bapshago/AngryPixieDash/AngryPixieDash_Reference.docx

Angry Pixie Dash

EV Dashboard · Porsche 928 / Nissan Leaf Stack / ZombieVerter

Uniboard PCB · Wiring · Configuration · Code Reference

Rev 1.0 · EasyEDA · Designed by Sayantan98

# 1. System Overview

The Angry Pixie Dash is a self-contained EV dashboard built around the Angry Pixie Garage Uniboard. The board integrates an ESP32-WROOM-32E module, SN65HVD230 CAN transceiver, 4-channel relay outputs, 5V buck converter, USB-C programming port, level-shifted GPIO outputs, and an optocoupler input — all on a single PCB designed to mount directly in the vehicle.

The firmware reads native Nissan Leaf CAN1 frames directly from the ZombieVerter CAN1 bus and serves a live web dashboard over a built-in WiFi access point. No external router or internet connection is required.

Key specifications:

• Microcontroller: ESP32-WROOM-32E, dual-core 240MHz, 4MB flash, WiFi + BLE

• CAN: SN65HVD230DR transceiver, 500 kbps, ISO 11898-2, onboard switchable termination

• Power input: 9–28V DC via CN4 (24V nominal), onboard 15A fuse, AP63205WU-7 buck to 5V

• Relay outputs: 4× SRD-5VDC-SL-A SPDT, 10A contacts, NO outputs on CN1

• Level-shifted outputs: GPIO21, GPIO23, GPIO33 available at 5V logic level

• Programming: USB-C via CH340C (auto-reset circuit included)

• WiFi: ESP32 soft AP — SSID: ESP32-EV-Dashboard, Password: evdash1234

• Web interface: http://192.168.4.1 (Driver View + Diagnostics pages)

# 2. Uniboard PCB

## 2.1 Board Overview

The Uniboard is a two-layer PCB with all components on the top side. Mounting holes are provided at four corners. The board is divided into functional zones visible in the PCB render:

• Top-left: relay cluster (K1-K4) with flyback diodes and transistor drivers

• Top-centre/right: JST XH output connectors (CN1-CN7)

• Centre: ESP32-WROOM-32E module with GPIO header breakouts H1 and H2

• Centre-left: USB-C connector, CH340C, auto-reset circuit, RST/BOOT buttons

• Centre-right: SN65HVD230 CAN transceiver, level shifters, termination jumpers

• Bottom-left: 24V input connector CN4 with fuse FH1 and AP63205WU-7 buck converter

• Bottom-centre: power indicator LED

## 2.2 Bill of Materials

All components sourced from LCSC. Key ICs and their roles:

Ref | Part | Qty | Function
U2 | ESP32-WROOM-32E (4MB) | 1 | Main microcontroller — WiFi, BLE, dual-core 240MHz, 4MB flash
U6 | SN65HVD230DR | 1 | CAN transceiver — 3.3V, connects ESP32 TWAI to CAN bus
U1 | AP2112K-3.3TRG1 | 1 | 3.3V LDO regulator — powers ESP32 and logic from 5V rail
U9 | AP63205WU-7 | 1 | 5V 2A buck converter — steps down vehicle 24V input to 5V
U5 | CH340C | 1 | USB-UART bridge — ESP32 programming and serial monitor
U3 | EL357N | 1 | Optocoupler — isolated digital input for OPTO signal
K1-4 | SRD-5VDC-SL-A | 4 | 5V SPDT relay — NO contacts rated for external switching
Q1 | MUN5214DW1T1G | 1 | Dual NPN pre-biased transistor — USB auto-reset (DTR/RTS)
Q2-5 | MMBT2222A | 4 | NPN transistor — relay coil drivers
Q6-8 | BSS138 | 3 | N-channel MOSFET — 3.3V to 5V logic level shifters
FH1 | PTF-15 | 1 | 15A blade fuse holder — protects 24V input supply
D1 | B5819W | 1 | Schottky diode — reverse polarity protection on VUSB
D2-5 | LL4148 | 4 | Signal diode — relay flyback suppression
L1 | 4.7uH | 1 | Inductor — buck converter output filter
R12 | 120Ω | 1 | CAN bus termination resistor — end-of-line termination
R10 | 10kΩ | 1 | SN65HVD230 RS pin pull-down — sets high-speed mode
JP1,JP2 | 2-pin jumper header | 2 | CAN termination jumper — in=terminated, out=unterminated
USB2 | USB-C connector | 1 | Programming and power input port
CN1 | B5B-XH-AM (5-pin) | 1 | Relay output connector — NO1-4 + GND
CN2-4 | B2B-XH-A (2-pin) | 3 | Bottom connectors — GND/P33, P21/P23, GND/D22
CN5 | B2B-XH-A (2-pin) | 1 | CAN bus connector — CANH / CANL
CN6 | B2B-XH-A (2-pin) | 1 | Level-shifted output — D23_H / D21_H
CN7 | B2B-XH-A (2-pin) | 1 | Level-shifted output — D33_H
H1,H2 | 10-pin header | 2 | ESP32 GPIO breakout — left and right pin rows

## 2.3 Connector Reference

All signal connectors use JST XH 2.54mm pitch. Mating connectors: JST XH series crimped housings.

Connector | Type | Function | Details
CN1 | B5B-XH 5-pin | Relay outputs | Pin1=NO1, Pin2=NO2, Pin3=NO3, Pin4=NO4, Pin5=GND. Relay contacts rated for load switching — see relay section for voltage limits.
CN2 | B2B-XH 2-pin | GND / GPIO33 | Pin1=GND, Pin2=GPIO33. Also exposed as D33_H (5V level) via CN7.
CN3 | B2B-XH 2-pin | GPIO21 / GPIO23 | Pin1=GPIO21, Pin2=GPIO23. Also exposed as D21_H / D23_H (5V level) via CN6.
CN4 | B2B-XH 2-pin | 24V power input | Pin1=+24V, Pin2=GND. Main vehicle power input — connect to run-mode switched supply. Protected by fuse FH1 (15A).
CN5 | B2B-XH 2-pin | CAN bus | Pin1=CANH, Pin2=CANL. Connect to ZombieVerter CAN1. Onboard 120Ω termination selectable via JP1/JP2.
CN6 | B2B-XH 2-pin | 5V logic out | Pin1=D23_H, Pin2=D21_H. BSS138 level-shifted versions of GPIO23 and GPIO21 — 5V compatible outputs.
CN7 | B2B-XH 2-pin | 5V logic out | Pin1=D33_H. BSS138 level-shifted version of GPIO33 — 5V compatible output.
USB2 | USB-C | Programming/power | CH340C USB-UART bridge. Use for firmware upload and serial monitor. Can also power board at 5V for bench use (bypasses buck converter).
H1 | 10-pin header | GPIO breakout (L) | D2, D4, D16, D17, D5, D18, D19, D21, D23, GND
H2 | 10-pin header | GPIO breakout (R) | +5V, D12, D27, D25, D33, D35, D34, D39, D36, 3V3

⚠ CN4 is the main 24V power input. Always connect via a fuse — the onboard PTF-15 fuse holder FH1 takes a standard 15A automotive blade fuse. Do not exceed 28V input.

# 3. Power System

The Uniboard has a dual-path power architecture. In vehicle use, 24V is supplied via CN4. On the bench, USB-C powers the logic via VUSB.

Rail | Source | Notes
24V input | CN4 — vehicle supply | Protected by 15A blade fuse FH1. Input to AP63205WU-7 buck converter. Also feeds relay coils via transistor drivers.
+5V rail | AP63205WU-7 buck converter | 2A continuous. Powers ESP32 VIN, CH340C, relay coils, and optocoupler. Also available at H2 pin 1 for accessories.
3.3V rail | AP2112K-3.3TRG1 LDO | 600mA max. Powers ESP32 3V3, SN65HVD230, BSS138 gate pulls. Available at H2 last pin.
VUSB | USB-C VBUS via B5819W Schottky | 5V from USB. Schottky diode prevents backfeed when 24V supply also present. Powers CH340C independently.

The AP63205WU-7 is a 2A synchronous buck converter. Input capacitor U4 (10uF electrolytic) and output capacitors C10/C11 (22uF each) filter the switching noise. Inductor L1 (4.7uH) is the buck output inductor. The 5V rail powers relay coils, ESP32 VIN, CH340C, and is available on H2.

⚠ The vehicle supply should be switched via the ZombieVerter run-mode contactor or a dedicated run-mode output so the dashboard powers off when the inverter shuts down. This prevents parasitic 12V drain when parked.

# 4. CAN Bus Interface

Item | Detail
Transceiver | SN65HVD230DR (Texas Instruments) — 3.3V, 1Mbps max, ISO 11898-2 compliant
ESP32 connection | CAN_TX → GPIO25 (ESP32 IO25 / TWAI TX) | CAN_RX → GPIO27 (ESP32 IO27 / TWAI RX)
RS pin | Pulled to GND via R10 (10kΩ) — sets high-speed mode. Do NOT leave floating.
Onboard termination | 120Ω resistor R12 between CANH and CANL. Enabled by fitting jumpers JP1 and JP2.
JP1 / JP2 | Both jumpers must be fitted together to enable termination. Remove both to unterminate (if ZombieVerter end already terminated).
CAN connector | CN5 — B2B-XH 2-pin: Pin1=CANH, Pin2=CANL
Decoupling | 100nF C12 on VCC pin of SN65HVD230
Bus speed | 500 kbps — set in firmware TWAI_TIMING_CONFIG_500KBITS()

## 4.1 Termination Jumpers JP1 and JP2

The board has an onboard 120Ω termination resistor R12 between CANH and CANL. This is controlled by two 2-pin jumper headers JP1 and JP2.

• JP1 and JP2 both fitted = termination ENABLED — use when the Uniboard is at one end of the CAN bus

• JP1 and JP2 both removed = termination DISABLED — use when another device at the same physical end already has termination

⚠ A CAN bus must have exactly two 120Ω termination resistors — one at each physical end. The ZombieVerter CAN1 port has its own termination. Check whether it is enabled before deciding whether to fit the Uniboard jumpers. Two terminations at the same end = 60Ω = communication errors.

## 4.2 CAN GPIO Assignment

The SN65HVD230 is connected to the ESP32 TWAI peripheral as follows:

CAN_TX_PIN GPIO_NUM_25 // ESP32 IO25 → SN65HVD230 D (transmit)

CAN_RX_PIN GPIO_NUM_27 // SN65HVD230 R (receive) → ESP32 IO27

⚠ These GPIO assignments are swapped from the default ESP32 TWAI example in most tutorials (which use GPIO21/GPIO22). The #define in ev_dashboard.ino already has the correct values for this board.

# 5. Relay Outputs

Item | Detail
Relays | 4× SRD-5VDC-SL-A — SPDT, 5V coil, 10A/250VAC / 10A/30VDC contact rating
Drivers | MMBT2222A NPN transistors Q2-Q5 — one per relay. Base resistors R2-R6 (1kΩ).
Flyback | LL4148 diodes D2-D5 across each relay coil — suppresses inductive kickback
Coil supply | +5V rail via collector-emitter of MMBT2222A
Load supply | 24V from CN4 is routed to relay common contacts — NO contacts go to CN1 pins
ESP32 control | RELAY1=GPIO26, RELAY2=GPIO33(?), RELAY3=GPIO13(?), RELAY4=GPIO14 — verify against schematic net labels
CN1 pinout | Pin1=NO1, Pin2=NO2, Pin3=NO3, Pin4=NO4, Pin5=GND
Max load | 10A per channel — use external contactor for higher current loads

Each relay is driven by an MMBT2222A NPN transistor. The ESP32 GPIO drives the transistor base through a 1kΩ resistor. When the GPIO is HIGH, the transistor saturates, energising the relay coil. The LL4148 flyback diode across each coil suppresses the voltage spike when the relay de-energises.

The relay NO (normally open) contacts are brought out on CN1. The 24V supply from CN4 is routed to the relay common contacts — switching the relay connects 24V to the relevant NO pin. Use these to switch accessories, indicators, or auxiliary contactors.

⚠ The relay contacts are rated 10A/30VDC. For higher current or voltage loads, use the relay to switch an external contactor rated for that load.

# 6. Level-Shifted GPIO Outputs

Three GPIO lines are available at 5V logic levels via BSS138 N-channel MOSFET level shifters (Q6, Q7, Q8). Each uses a standard open-drain level shift topology with 10kΩ pull-ups to both 3.3V and 5V rails.

Signal | Detail
D23 → D23_H | BSS138 Q7 with 10kΩ pull-ups to 3.3V and 5V. Open-drain level shift: 3.3V ESP32 output → 5V compatible signal on CN6 pin1
D21 → D21_H | BSS138 Q6 — same circuit. CN6 pin2
D33 → D33_H | BSS138 Q8 — same circuit. CN7 pin1
Purpose | Allows ESP32 3.3V GPIO to drive 5V logic devices such as external displays, relays, or sensors that require 5V signalling

These outputs are useful for driving 5V peripherals such as external shift registers, 5V-logic displays, or other microcontrollers that are not 3.3V tolerant.

# 7. Optocoupler Input (OPTO)

The EL357N optocoupler (U3) provides an isolated digital input. The anode is driven via CN2 through a 2.2kΩ current-limiting resistor R7, with a 10kΩ pull-up R8 to 3.3V on the output side. The output connects to ESP32 GPIO22 (IO22).

This input is electrically isolated from the ESP32, making it suitable for reading signals from higher-voltage systems without risking damage to the ESP32. Typical use: external enable signal, charge detection, or door/contact input.

Input threshold: approximately 1.2V forward voltage on LED side. The 2.2kΩ resistor limits LED current at 3.3V to ~0.9mA — sufficient for reliable switching.

# 8. Programming the Board

## 8.1 USB-C Port

Connect the board to a laptop via USB-C. The CH340C USB-UART bridge appears as a COM port (Windows) or /dev/ttyUSB0 or /dev/ttyACM0 (Linux/Mac). Install CH340 drivers if the port does not appear.

The auto-reset circuit (Q1 MUN5214DW1T1G dual NPN) allows Arduino IDE to automatically reset the ESP32 into bootloader mode using the RTS and DTR lines — no need to hold BOOT and press RST manually.

## 8.2 Arduino IDE Settings

Board: ESP32 Dev Module

Upload Speed: 921600

CPU Frequency: 240 MHz

Flash Size: 4MB

Partition Scheme: Default 4MB with spiffs

Port: Select the CH340 COM port

## 8.3 Manual Boot Mode

If auto-reset fails, enter bootloader manually:

1. Hold BOOT button

2. Press and release RST button

3. Release BOOT button

4. Click Upload in Arduino IDE

⚠ The 24V supply does not need to be connected for programming. USB-C alone powers the ESP32 and CH340C via the VUSB rail.

# 9. Wiring to ZombieVerter

Board Point | Signal | Destination | Notes
CN5 Pin1 | CANH | ZombieVerter CAN1 CANH | Twisted pair recommended
CN5 Pin2 | CANL | ZombieVerter CAN1 CANL | Twisted pair recommended
CN4 Pin1 | +24V | Vehicle run-mode switched supply | Via 15A fuse FH1 already on board
CN4 Pin2 | GND | Vehicle chassis ground
USB2 | USB-C | Laptop for programming | CH340C — use for firmware upload only
JP1+JP2 | fitted | CAN termination enabled | Fit both jumpers if board is at end of CAN bus
JP1+JP2 | removed | CAN termination disabled | Remove if another device terminates this end

Use twisted pair cable for CANH/CANL. Keep the CAN wiring away from high-current motor/battery cables. Recommended wire gauge for 24V power: 20AWG minimum, 18AWG preferred for runs over 500mm.

# 10. ZombieVerter Configuration

## 10.1 CAN Parameters

• canspeed = 500000 (must match firmware TWAI_TIMING_CONFIG_500KBITS)

• canmapcan = can1 (user TX messages broadcast on CAN1 where Uniboard is connected)

## 10.2 Required TX Entries

Enter in ZombieVerter command line:

can tx drivedir 794 0 8 1 0

can tx opmode 794 8 8 1 0

save

Power cycle after saving. Verify with the CAN sniffer that 0x31A (794 decimal) appears on the bus.

# 11. CAN Frame Reference (Native Leaf Frames)

The firmware reads these Leaf CAN1 frames directly. No ZombieVerter CAN map RX entries are needed.

### 0x1DA / 474

voltage = ((bytes[0] << 2) | (bytes[1] >> 6)) × 0.5 // V, 10-bit

speed = int16(bytes[4]<<8 | bytes[5]) × 0.5 // RPM

error = (bytes[6] & 0xB0) != 0x00 // fault flags

### 0x55A / 1370

motor_temp_c = fahrenheit_to_celsius(bytes[1])

inverter_temp_c = fahrenheit_to_celsius(bytes[2])

### 0x55B / 1371

soc = ((bytes[0]<<2) | (bytes[1]>>6)) × 0.1 // % (25% = raw 250 = 0x00FA)

### 0x1DB / 475

cur = ((bytes[0]<<3) | (bytes[1]>>5))

if (cur > 1023) cur -= 2047 // 11-bit signed correction

### 0x390 / 912

OBCVoltStat = (bytes[3]>>3) & 0x03

PlugStat = bytes[5] & 0x0F // 0x08 = plugged in

### 0x31A / 794 (ZombieVerter TX)

drivedir = int8(bytes[0]) // -1=Reverse 0=Neutral 1=Forward

opmode = int8(bytes[1]) // 0=Off 1=Run 2=PreCharge 3=Fail 4=Charging

# 12. Code File Structure

ev_dashboard/

ev_dashboard.ino ← main sketch — open this in Arduino IDE

driverpage.h ← driver dashboard HTML

diagnosticpage.h ← diagnostics page HTML

can_sniffer/

can_sniffer.ino ← separate sketch for CAN bus debugging

⚠ Do NOT place can_sniffer.ino inside the ev_dashboard folder.

# 13. WiFi and Web Interface

SSID: ESP32-EV-Dashboard

Password: evdash1234

Dashboard: http://192.168.4.1/

Diagnostics: http://192.168.4.1/diagnostics

API: http://192.168.4.1/api/data (JSON, 500ms poll)

CAN Sniffer: http://192.168.4.1/ (when can_sniffer.ino is loaded)

# 14. Troubleshooting

## No data / all gauges show --

1. Check Serial Monitor (115200 baud) — TWAI Init OK should appear

2. Verify CANH/CANL not swapped at CN5

3. Check JP1+JP2 jumper configuration vs ZombieVerter termination

4. Flash can_sniffer.ino — connect to CAN_Sniffer WiFi, open http://192.168.4.1

5. If Total Frames = 0 → wiring or termination fault

6. If frames present but no 0x1DA/0x55A/0x55B → Leaf BMS not on CAN1 or wrong bus

## Power LED off / no WiFi AP

1. Check 24V supply at CN4 and fuse FH1

2. Try USB-C alone — if WiFi appears, 24V supply is the issue

3. Check AP63205WU-7 output — should be 5.0V at H2 pin1

## Upload fails via USB-C

1. Install CH340 drivers if COM port not visible

2. Try manual bootloader mode (BOOT + RST)

3. Reduce upload speed to 460800 in Arduino IDE board settings

## Known code issues (current version)

⚠ diagnosticpage.h has duplicate id='stateofcharge' and duplicate id='error' — second instance will not update in some browsers. Remove duplicate divs.

⚠ driverpage.h catch block references bare 'opmode' identifier — will throw ReferenceError. Remove 'opmode' from the catch line.

✔ Both issues are cosmetic — dashboard functions correctly despite them.

Angry Pixie Garage · www.theangrypixiegarage.com · Porsche 928 EV · ZombieVerter 2.3 · Uniboard Rev 1.0
