bapshago/AngryPixieDash/hardware/board-bottom.png

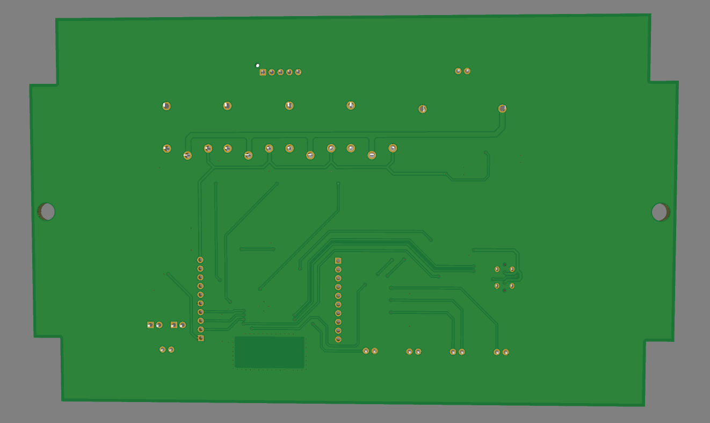
hardware/board-bottom.png
