bapshago/AngryPixieDash/hardware/Schematic.pdf

# CAN_TXCAN_TX CAN_RX

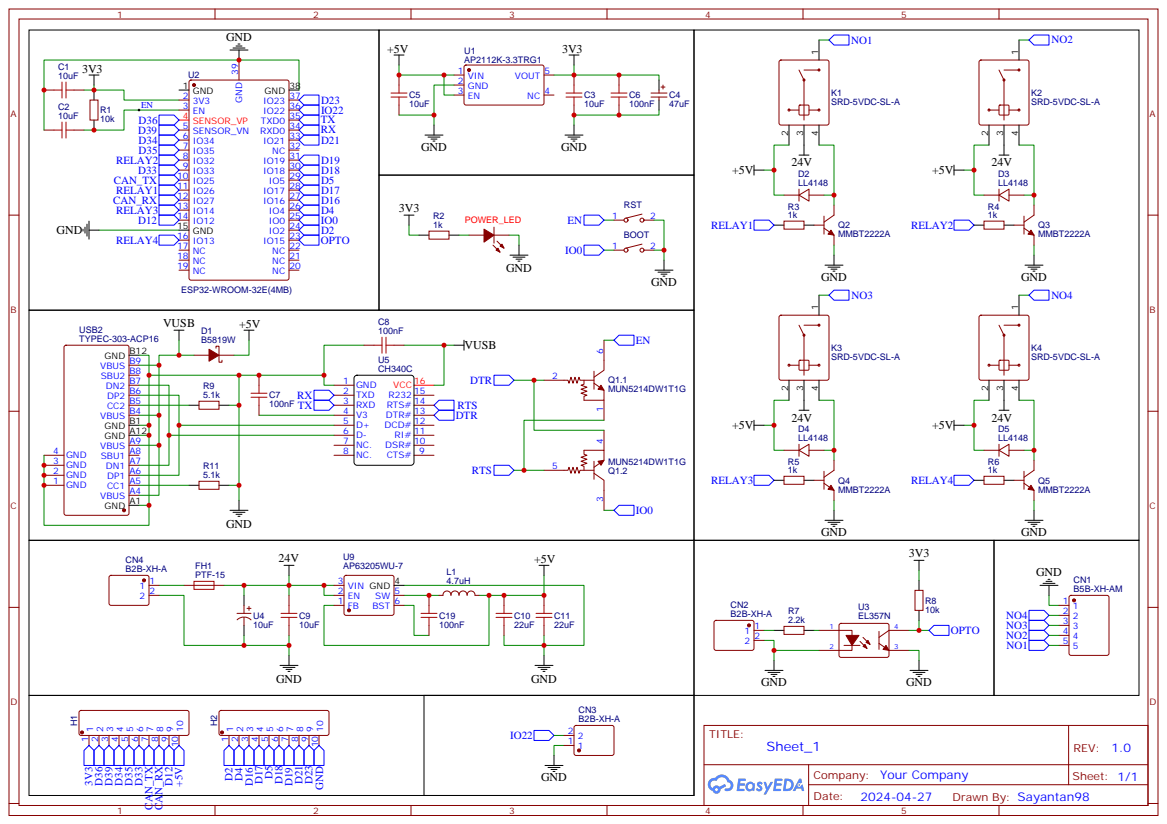
[picture p3: page 1]

ESP32-WROOM-32E(4MB)
GND A1 VBUS A4 CC1 A5 DP1 A6 DN1 A7 SBU1 A8 VBUS A9 GND A12 GND B1 VBUS B4 CC2 B5 DP2 B6 DN2 B7 SBU2 B8 VBUS B9 GND B12

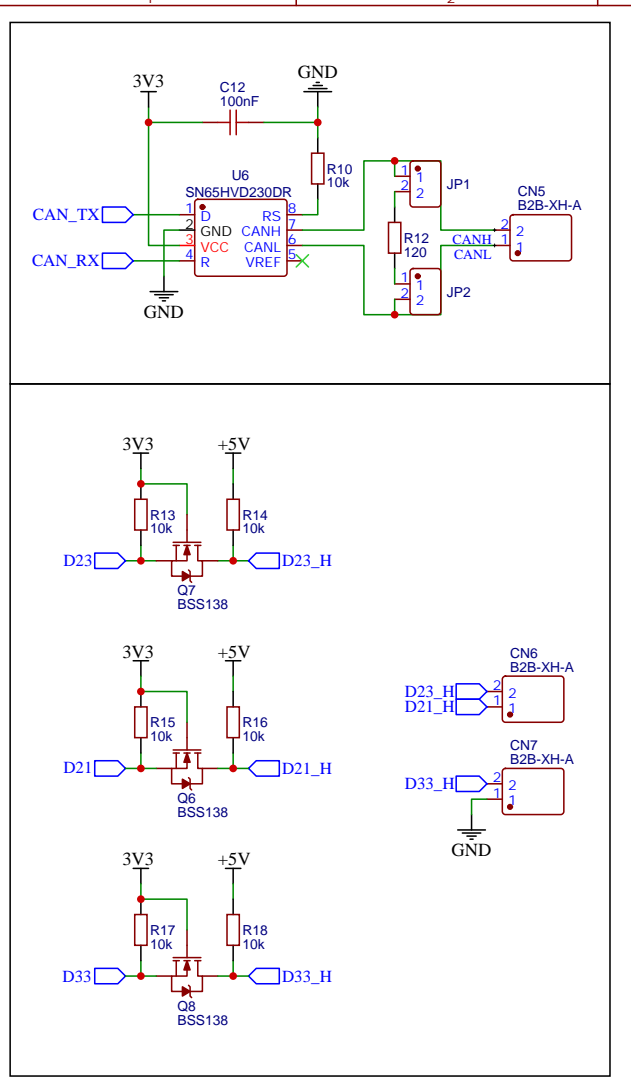
[picture p4: page 2]
