bapshago/AngryPixieDash/(commit log)

2026-07-06 Initial commit: Angry Pixie Dash ESP32 EV dashboard
    Web dashboard for a Porsche 928 EV conversion. ESP32 reads Nissan
    Leaf / ZombieVerter CAN data and serves an iPad-optimized driver page
    and a diagnostics page over its own WiFi AP.
2026-07-06 Add hardware folder with Angry Pixie UniBoard design files
    Schematic, gerbers, BOM (LCSC part numbers), pick-and-place, board
    renders, and a README documenting the power/CAN/relay blocks, ESP32
    pin map, and connector pinouts.
    [BOM.csv, PickAndPlace.csv]
2026-07-06 Fix swapped CAN pin assignments in reference doc
    The schematic shows CAN_TX on GPIO25 and CAN_RX on GPIO27; the doc had
    them reversed, which matched neither the board nor the working sketch.
2026-07-06 Extend red bezel band around gear indicator and charge section
    The band now wraps everything from the speed gauge down through the
    SOC bar, range, and time-to-full estimate.
2026-07-06 Show whole numbers on all driver page readouts
    Gauge values, SOC percentage, and range estimate now round to
    integers instead of showing one decimal place.
2026-07-06 Swap current and 12V gauges, enlarge the current dial
    Current gauge moves to the center column with a 70px-radius dial in a
    165px box (was 48px in 190px), so the dial grows while the cluster
    gets slightly narrower. 12V gauge joins voltage in the left column.
2026-07-06 Add captive-portal DNS and connectivity-check endpoints
    Ported from bapshago/bapshago fixesp32wifireconnect.ino: a wildcard
    DNS server answers every lookup with the AP IP, and the OS
    connectivity probes (Android /generate_204, Apple
    /hotspot-detect.html, Windows /connecttest.txt + /ncsi.txt) get
    success responses so tablets treat the AP as online and stay
    connected automatically.
    [leaf_dash_v9.ino]
2026-07-06 Add 0x31A raw-frame diagnostics for the 12V uaux mapping
    The 12V gauge read zero in the car because ZombieVerter is not yet
    mapping uaux onto 0x31A bytes 2-3. Diagnostics page now shows the raw
    0x31A frame hex so the mapping can be verified, and the gauge shows
    -- instead of 0 V until real data arrives.
2026-07-06 Document the three required ZombieVerter CAN TX mappings
    New ZombieVerter_CAN_Mappings.md covers the drivedir/opmode/uaux
    mappings on 0x31A, the resulting frame layout, web UI steps, and how
    to verify with the diagnostics raw-frame readout.
2026-07-06 Add Fire tablet setup guide for ignition-follow display
    Tablet_Setup.md documents the Fully Kiosk Browser configuration
    (screen on/off with USB power, boot to dashboard) plus the no-app
    fallback using developer options. Linked from README along with the
    CAN mapping doc.
